RISC-V-Azedinha/RISC-V/figura_double_buffering_tcc.png

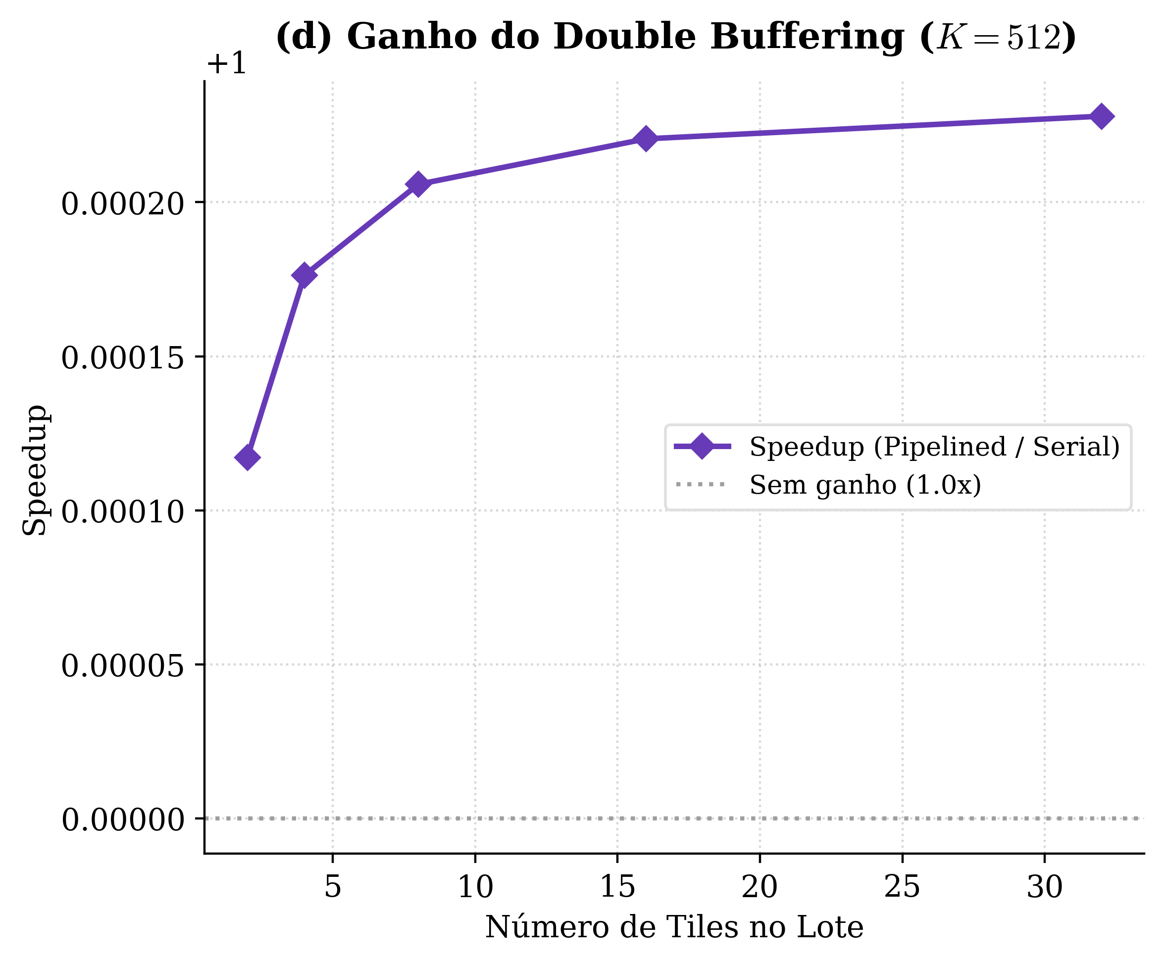
figura_double_buffering_tcc.png
