RISC-V-Azedinha/RISC-V/tight_setup_hold_pins.txt

+====================+===================+=======================================================================+
| Launch Setup Clock | Launch Hold Clock | Pin                                                                   |
+====================+===================+=======================================================================+
| sys_clk_pin        | sys_clk_pin       | U_CORE/U_CONTROLPATH/u_main_fsm/FSM_sequential_current_state_reg[1]/D |
+--------------------+-------------------+-----------------------------------------------------------------------+
