RISC-V-Azedinha/RISC-V/rtl/soc/soc_top.vhd

------------------------------------------------------------------------------------------------------------------
-- 
-- File: soc_top.vhd
-- 
--   ███████╗ ██████╗  ██████╗    ████████╗ ██████╗ ██████╗ 
--   ██╔════╝██╔═══██╗██╔════╝    ╚══██╔══╝██╔═══██╗██╔══██╗
--   ███████╗██║   ██║██║            ██║   ██║   ██║██████╔╝
--   ╚════██║██║   ██║██║            ██║   ██║   ██║██╔═══╝ 
--   ███████║╚██████╔╝╚██████╗       ██║   ╚██████╔╝██║     
--   ╚══════╝ ╚═════╝  ╚═════╝       ╚═╝    ╚═════╝ ╚═╝     
-- 
-- Descrição : Top-level do SoC RISC-V.
--             Integra o núcleo processador com memórias e periféricos reais.
--             Arquitetura: Harvard Modificada com Crossbar e DMA Dual-Master.
-- 
------------------------------------------------------------------------------------------------------------------

library ieee;
use ieee.std_logic_1164.all;
use ieee.numeric_std.all;

entity soc_top is
    generic (
        INIT_FILE : string  := "build/fpga/boot/bootloader.hex";
        CLK_FREQ  : integer := 100_000_000;  
        BAUD_RATE : integer := 921_600;
        BAUD_RATE_UART2 : integer := 115_200     -- UART2 no Pmod JA (ex.: ponte Bluetooth com um ESP32)
    );
    port (
        CLK_i       : in  std_logic;         
        Reset_i     : in  std_logic;         
        
        UART_TX_o   : out std_logic;         
        UART_RX_i   : in  std_logic;         
        UART_RTS_i  : in  std_logic;         

        GPIO_LEDS_o : out std_logic_vector(15 downto 0);
        GPIO_SW_i   : in  std_logic_vector(15 downto 0);
        GPIO_BTN_i  : in  std_logic_vector( 3 downto 0) := (others => '0');   -- BTNU, BTND, BTNL, BTNR

        -- Pmods JA..JD (bit i = pino i da porta: pinos 1-4 e 7-10 do conector)
        PMOD_JA_io  : inout std_logic_vector(7 downto 0);
        PMOD_JB_io  : inout std_logic_vector(7 downto 0);
        PMOD_JC_io  : inout std_logic_vector(7 downto 0);
        PMOD_JD_io  : inout std_logic_vector(7 downto 0);

        -- LEDs RGB LD16 e LD17 (bit 0 = R, 1 = G, 2 = B)
        RGB0_o      : out std_logic_vector(2 downto 0);
        RGB1_o      : out std_logic_vector(2 downto 0);

        VGA_HS_o    : out std_logic;
        VGA_VS_o    : out std_logic;
        VGA_R_o     : out std_logic_vector(3 downto 0);
        VGA_G_o     : out std_logic_vector(3 downto 0);
        VGA_B_o     : out std_logic_vector(3 downto 0);

        -- Displays de 7 segmentos (ativos em nível baixo)
        SEG_CAT_o   : out std_logic_vector(6 downto 0);                       -- CA..CG
        SEG_DP_o    : out std_logic;
        SEG_AN_o    : out std_logic_vector(7 downto 0);

        -- Slot de microSD (modo SPI)
        SD_SCK_o    : out std_logic;
        SD_CMD_o    : out std_logic;                                          -- MOSI
        SD_DAT0_i   : in  std_logic := '1';                                   -- MISO
        SD_DAT_o    : out std_logic_vector(3 downto 1);                       -- DAT3 = CS; DAT1 e DAT2 em 1
        SD_RESET_o  : out std_logic;                                          -- 1 = cartão sem alimentação
        SD_CD_i     : in  std_logic := '1'                                    -- 0 = cartão no slot
    );
end entity;

architecture rtl of soc_top is

    -- === Sinais da CPU ==========================================================================================
    signal s_cpu_imem_addr   : std_logic_vector(31 downto 0);
    signal s_cpu_imem_data   : std_logic_vector(31 downto 0);
    signal s_cpu_imem_vld    : std_logic;
    signal s_cpu_imem_rdy    : std_logic;

    signal s_cpu_dmem_addr   : std_logic_vector(31 downto 0);
    signal s_cpu_dmem_wdata  : std_logic_vector(31 downto 0);
    signal s_cpu_dmem_rdata  : std_logic_vector(31 downto 0);
    signal s_cpu_dmem_we     : std_logic_vector( 3 downto 0);
    signal s_cpu_dmem_vld    : std_logic;
    signal s_cpu_dmem_rdy    : std_logic;

    -- === Sinais do DMA ==========================================================================================
    signal s_dma_m_rd_addr   : std_logic_vector(31 downto 0);
    signal s_dma_m_rd_data   : std_logic_vector(31 downto 0);
    signal s_dma_m_rd_vld    : std_logic;
    signal s_dma_m_rd_rdy    : std_logic;

    signal s_dma_m_wr_addr   : std_logic_vector(31 downto 0);
    signal s_dma_m_wr_data   : std_logic_vector(31 downto 0);
    signal s_dma_m_wr_we     : std_logic;
    signal s_dma_m_wr_vld    : std_logic;
    signal s_dma_m_wr_rdy    : std_logic;

    signal s_dma_s_addr      : std_logic_vector(3 downto 0);
    signal s_dma_s_wdata     : std_logic_vector(31 downto 0);
    signal s_dma_s_rdata     : std_logic_vector(31 downto 0);
    signal s_dma_s_we        : std_logic;
    signal s_dma_s_vld       : std_logic;
    signal s_dma_s_rdy       : std_logic;

    -- === Sinais de Interconexão (Periféricos e Memórias) ========================================================
    signal s_rom_addr_a, s_rom_addr_b : std_logic_vector(31 downto 0);
    signal s_rom_data_a, s_rom_data_b : std_logic_vector(31 downto 0);
    signal s_rom_vld_a, s_rom_rdy_a   : std_logic;
    signal s_rom_vld_b, s_rom_rdy_b   : std_logic;

    signal s_ram_addr_a, s_ram_addr_b : std_logic_vector(31 downto 0);
    signal s_ram_data_a, s_ram_data_b : std_logic_vector(31 downto 0);     
    signal s_ram_data_w               : std_logic_vector(31 downto 0);
    signal s_ram_we_b                 : std_logic_vector( 3 downto 0);
    signal s_ram_vld_a, s_ram_rdy_a   : std_logic;
    signal s_ram_vld_b, s_ram_rdy_b   : std_logic;

    signal s_uart_addr                : std_logic_vector( 3 downto 0);
    signal s_uart_data_rx             : std_logic_vector(31 downto 0);
    signal s_uart_data_tx             : std_logic_vector(31 downto 0);
    signal s_uart_we                  : std_logic;
    signal s_uart_vld, s_uart_rdy     : std_logic;

    signal s_gpio_addr                : std_logic_vector(9 downto 0);
    signal s_gpio_data_rx             : std_logic_vector(31 downto 0);                 
    signal s_gpio_data_tx             : std_logic_vector(31 downto 0);
    signal s_gpio_we                  : std_logic;
    signal s_gpio_vld, s_gpio_rdy     : std_logic;

    signal s_vga_addr                 : std_logic_vector(16 downto 0);
    signal s_vga_data_rx              : std_logic_vector(31 downto 0);                  
    signal s_vga_data_tx              : std_logic_vector(31 downto 0);
    signal s_vga_we                   : std_logic;
    signal s_vga_vld, s_vga_rdy       : std_logic;

    signal s_npu_addr                 : std_logic_vector(31 downto 0);
    signal s_npu_data_rx              : std_logic_vector(31 downto 0);                 
    signal s_npu_data_tx              : std_logic_vector(31 downto 0);
    signal s_npu_we                   : std_logic;
    signal s_npu_vld, s_npu_rdy       : std_logic;
    signal s_npu_rst_n                : std_logic;

    signal s_clint_addr               : std_logic_vector(4 downto 0);
    signal s_clint_data_rx            : std_logic_vector(31 downto 0);
    signal s_clint_data_tx            : std_logic_vector(31 downto 0);
    signal s_clint_we                 : std_logic;
    signal s_clint_vld, s_clint_rdy   : std_logic;

    signal s_plic_addr                : std_logic_vector(23 downto 0);
    signal s_plic_data_rx             : std_logic_vector(31 downto 0);
    signal s_plic_data_tx             : std_logic_vector(31 downto 0);
    signal s_plic_we                  : std_logic;
    signal s_plic_vld, s_plic_rdy     : std_logic;

    signal s_sd_addr                  : std_logic_vector(3 downto 0);
    signal s_sd_data_rx               : std_logic_vector(31 downto 0);
    signal s_sd_data_tx               : std_logic_vector(31 downto 0);
    signal s_sd_we                    : std_logic;
    signal s_sd_vld, s_sd_rdy         : std_logic;

    signal s_uart2_addr               : std_logic_vector(3 downto 0);
    signal s_uart2_data_rx            : std_logic_vector(31 downto 0);
    signal s_uart2_data_tx            : std_logic_vector(31 downto 0);
    signal s_uart2_we                 : std_logic;
    signal s_uart2_vld, s_uart2_rdy   : std_logic;

    -- === Auxiliares =============================================================================================
    signal s_irq_external             : std_logic;
    signal s_irq_timer                : std_logic;
    signal s_irq_soft                 : std_logic;

    signal s_uart_irq                 : std_logic;
    signal s_dma_irq                  : std_logic;
    signal s_npu_irq                  : std_logic;
    signal s_plic_sources             : std_logic_vector(31 downto 0);
    signal s_gpio_irq                 : std_logic;
    signal s_uart2_irq                : std_logic;

    -- Pmods: valor, habilitação de saída (tri-state) e leitura de cada pino
    signal s_ja_o, s_jb_o, s_jc_o, s_jd_o     : std_logic_vector(7 downto 0);
    signal s_ja_oe, s_jb_oe, s_jc_oe, s_jd_oe : std_logic_vector(7 downto 0);

    -- UART2 no Pmod JA: quando habilitada (bit EN), toma os pinos 2 (TX) e 3 (RX); senão, são GPIO
    signal s_uart2_en                 : std_logic;
    signal s_uart2_tx, s_uart2_rx     : std_logic;
    signal s_ja_pin_o, s_ja_pin_oe    : std_logic_vector(7 downto 0);

    -- === Controle de DEBUG ======================================================================================
    signal s_soc_en                   : std_logic;
    signal s_soc_en_sys               : std_logic := '1'; -- PIPELINE: Atraso de 1 ciclo para periféricos
    signal s_is_fetch_stage           : std_logic;
    signal s_debug_rst                : std_logic;
    signal s_sys_rst                  : std_logic;

    signal s_uart_rx_soc              : std_logic;
    signal s_uart_rx_debug            : std_logic;
    signal s_uart_tx_soc              : std_logic;
    signal s_uart_tx_debug            : std_logic;

    signal s_debug_reg_addr           : std_logic_vector(4 downto 0);
    signal s_debug_reg_data           : std_logic_vector(31 downto 0);
    signal s_dbg_boot_addr            : std_logic_vector(31 downto 0);
    signal s_dbg_reg_clr              : std_logic;

begin

    -- ============================================================================================================
    -- PIPELINE DO SINAL DE DEBUG (QUEBRA O CRITICAL PATH)
    -- ============================================================================================================
    process(CLK_i)
    begin
        if rising_edge(CLK_i) then
            s_soc_en_sys <= s_soc_en;
        end if;
    end process;

    -- ============================================================================================================
    -- CONTROLE DE RESET E INTERRUPÇÕES
    -- ============================================================================================================
    s_sys_rst <= Reset_i OR s_debug_rst;

    s_plic_sources <= (
        1 => s_uart_irq, 
        2 => s_dma_irq,
        3 => s_npu_irq,
        4 => s_gpio_irq,
        5 => s_uart2_irq,
        others => '0'
    );

    -- ============================================================================================================
    -- MULTIPLEXAÇÃO FÍSICA DE DEBUG VIA RTS
    -- ============================================================================================================
    s_uart_rx_soc   <= UART_RX_i when UART_RTS_i = '0' else '1';
    s_uart_rx_debug <= UART_RX_i when UART_RTS_i = '1' else '1';
    
    -- O TX usa o sinal system-level pipelined para prevenir timing violations na board
    UART_TX_o       <= s_uart_tx_debug when (UART_RTS_i = '1' or s_soc_en_sys = '0') else s_uart_tx_soc;

    -- ============================================================================================================
    -- DEBUG CONTROLLER
    -- ============================================================================================================
    U_DEBUG: entity work.debug_controller
        generic map (
            CLK_FREQ         => CLK_FREQ,
            BAUD_RATE        => BAUD_RATE
        )
        port map (
            clk_i            => CLK_i,
            rst_i            => Reset_i,
            dbg_boot_addr_o  => s_dbg_boot_addr,
            dbg_reg_clr_o    => s_dbg_reg_clr,
            uart_rx_i        => s_uart_rx_debug,
            uart_tx_o        => s_uart_tx_debug,
            uart_rts_i       => UART_RTS_i,
            is_fetch_stage_i => s_is_fetch_stage,
            soc_en_o         => s_soc_en,
            debug_rst_o      => s_debug_rst,
            reg_addr_o       => s_debug_reg_addr,
            reg_data_i       => s_debug_reg_data,
            pc_i             => s_cpu_imem_addr
        );

    -- ============================================================================================================
    -- NÚCLEO PROCESSADOR (CPU)
    -- ============================================================================================================
    U_CORE: entity work.processor_top
        port map (
            CLK_i               => CLK_i,
            Reset_i             => s_sys_rst,
            dbg_boot_addr_i     => s_dbg_boot_addr,
            dbg_reg_clr_i       => s_dbg_reg_clr,
            soc_en_i            => s_soc_en, -- MANTÉM COMBINACIONAL para travagem instantânea do PC
            is_fetch_stage_o    => s_is_fetch_stage,
            debug_reg_addr_i    => s_debug_reg_addr,
            debug_reg_data_o    => s_debug_reg_data,
            IMem_addr_o         => s_cpu_imem_addr,
            IMem_data_i         => s_cpu_imem_data,
            IMem_vld_o          => s_cpu_imem_vld, 
            IMem_rdy_i          => s_cpu_imem_rdy,
            DMem_addr_o         => s_cpu_dmem_addr,
            DMem_data_o         => s_cpu_dmem_wdata,
            DMem_data_i         => s_cpu_dmem_rdata,
            DMem_we_o           => s_cpu_dmem_we,
            DMem_rdy_i          => s_cpu_dmem_rdy,
            DMem_vld_o          => s_cpu_dmem_vld,
            Irq_External_i      => s_irq_external,
            Irq_Timer_i         => s_irq_timer,
            Irq_Software_i      => s_irq_soft
        );

    -- ============================================================================================================
    -- DMA CONTROLLER (Dual-Master)
    -- ============================================================================================================
    U_DMA: entity work.dma_controller
        port map (
            clk_i       => CLK_i,
            rst_i       => s_sys_rst,
            soc_en_i    => s_soc_en_sys, -- PIPELINE: Resolve a Violação de Timing de -4.271ns
            
            -- Slave (Config)
            cfg_addr_i  => s_dma_s_addr,
            cfg_data_i  => s_dma_s_wdata, 
            cfg_data_o  => s_dma_s_rdata, 
            cfg_we_i    => s_dma_s_we,
            cfg_vld_i   => s_dma_s_vld,
            cfg_rdy_o   => s_dma_s_rdy,
            
            -- Master Read (Source)
            m_rd_addr_o => s_dma_m_rd_addr,
            m_rd_vld_o  => s_dma_m_rd_vld,
            m_rd_data_i => s_dma_m_rd_data,
            m_rd_rdy_i  => s_dma_m_rd_rdy,

            -- Master Write (Destino)
            m_wr_addr_o => s_dma_m_wr_addr,
            m_wr_data_o => s_dma_m_wr_data,
            m_wr_we_o   => s_dma_m_wr_we,
            m_wr_vld_o  => s_dma_m_wr_vld,
            m_wr_rdy_i  => s_dma_m_wr_rdy,
            
            irq_done_o  => s_dma_irq
        );

    -- ============================================================================================================
    -- HUB DE INTERCONEXÃO (CROSSBAR INTERCONNECT)
    -- ============================================================================================================
    U_BUS: entity work.bus_interconnect
        port map (
            -- Sinais Globais
            clk_i => CLK_i,
            rst_i => s_sys_rst,

            -- Interface Core: IMem (CPU Direto)
            imem_addr_i => s_cpu_imem_addr,
            imem_data_o => s_cpu_imem_data,
            imem_vld_i  => s_cpu_imem_vld, 
            imem_rdy_o  => s_cpu_imem_rdy,

            -- Master 0: CPU DMem 
            cpu_addr_i  => s_cpu_dmem_addr,
            cpu_data_i  => s_cpu_dmem_wdata,
            cpu_we_i    => s_cpu_dmem_we,
            cpu_vld_i   => s_cpu_dmem_vld,
            cpu_data_o  => s_cpu_dmem_rdata,
            cpu_rdy_o   => s_cpu_dmem_rdy,

            -- Master 1: DMA Read
            dma_rd_addr_i => s_dma_m_rd_addr,
            dma_rd_vld_i  => s_dma_m_rd_vld,
            dma_rd_data_o => s_dma_m_rd_data,
            dma_rd_rdy_o  => s_dma_m_rd_rdy,

            -- Master 2: DMA Write
            dma_wr_addr_i => s_dma_m_wr_addr,
            dma_wr_data_i => s_dma_m_wr_data,
            dma_wr_we_i   => s_dma_m_wr_we,
            dma_wr_vld_i  => s_dma_m_wr_vld,
            dma_wr_rdy_o  => s_dma_m_wr_rdy,

            -- Interface ROM
            rom_addr_a_o => s_rom_addr_a, rom_data_a_i => s_rom_data_a,
            rom_addr_b_o => s_rom_addr_b, rom_data_b_i => s_rom_data_b,
            rom_vld_a_o  => s_rom_vld_a,  rom_rdy_a_i  => s_rom_rdy_a,
            rom_vld_b_o  => s_rom_vld_b,  rom_rdy_b_i  => s_rom_rdy_b,

            -- Interface RAM
            ram_addr_a_o => s_ram_addr_a, ram_data_a_i => s_ram_data_a,
            ram_addr_b_o => s_ram_addr_b, ram_data_b_i => s_ram_data_b,
            ram_data_b_o => s_ram_data_w,                      
            ram_we_b_o   => s_ram_we_b,
            ram_vld_a_o  => s_ram_vld_a,  ram_rdy_a_i  => s_ram_rdy_a,
            ram_vld_b_o  => s_ram_vld_b,  ram_rdy_b_i  => s_ram_rdy_b,

            -- Interface UART
            uart_addr_o  => s_uart_addr,    uart_data_i  => s_uart_data_rx,
            uart_data_o  => s_uart_data_tx, uart_we_o    => s_uart_we,
            uart_vld_o   => s_uart_vld,     uart_rdy_i   => s_uart_rdy,

            -- Interface GPIO
            gpio_addr_o  => s_gpio_addr,    gpio_data_i  => s_gpio_data_rx,
            gpio_data_o  => s_gpio_data_tx, gpio_we_o    => s_gpio_we,
            gpio_vld_o   => s_gpio_vld,     gpio_rdy_i   => s_gpio_rdy,

            -- Interface VGA
            vga_addr_o   => s_vga_addr,     vga_data_i   => s_vga_data_rx,
            vga_data_o   => s_vga_data_tx,  vga_we_o     => s_vga_we,
            vga_vld_o    => s_vga_vld,      vga_rdy_i    => s_vga_rdy,

            -- Interface NPU 
            npu_addr_o   => s_npu_addr,     npu_data_i   => s_npu_data_rx,
            npu_data_o   => s_npu_data_tx,  npu_we_o     => s_npu_we,
            npu_vld_o    => s_npu_vld,      npu_rdy_i    => s_npu_rdy,
            
            -- DMA Slave (Config)
            dma_addr_o   => s_dma_s_addr,
            dma_data_i   => s_dma_s_rdata, 
            dma_data_o   => s_dma_s_wdata, 
            dma_we_o     => s_dma_s_we,
            dma_vld_o    => s_dma_s_vld,
            dma_rdy_i    => s_dma_s_rdy,

            -- Interface CLINT
            clint_addr_o  => s_clint_addr,
            clint_data_i  => s_clint_data_rx,
            clint_data_o  => s_clint_data_tx,
            clint_we_o    => s_clint_we,
            clint_vld_o   => s_clint_vld,
            clint_rdy_i   => s_clint_rdy,

            -- Interface PLIC
            plic_addr_o   => s_plic_addr, 
            plic_data_i   => s_plic_data_rx, 
            plic_data_o   => s_plic_data_tx, 
            plic_we_o     => s_plic_we, 
            plic_vld_o    => s_plic_vld, 
            plic_rdy_i    => s_plic_rdy,

            -- Interface do cartão SD
            sd_addr_o     => s_sd_addr,
            sd_data_i     => s_sd_data_rx,
            sd_data_o     => s_sd_data_tx,
            sd_we_o       => s_sd_we,
            sd_vld_o      => s_sd_vld,
            sd_rdy_i      => s_sd_rdy,

            -- Interface da UART2 (Pmod JA)
            uart2_addr_o  => s_uart2_addr,
            uart2_data_i  => s_uart2_data_rx,
            uart2_data_o  => s_uart2_data_tx,
            uart2_we_o    => s_uart2_we,
            uart2_vld_o   => s_uart2_vld,
            uart2_rdy_i   => s_uart2_rdy
        );

    -- ============================================================================================================
    -- COMPONENTES DO SISTEMA
    -- ============================================================================================================

    U_ROM: entity work.boot_rom
        generic map ( INIT_FILE => INIT_FILE )
        port map (
            clk      => CLK_i,
            vld_a_i  => s_rom_vld_a, rdy_a_o  => s_rom_rdy_a, addr_a_i => s_rom_addr_a, data_a_o => s_rom_data_a,
            vld_b_i  => s_rom_vld_b, addr_b_i => s_rom_addr_b, data_b_o => s_rom_data_b, rdy_b_o  => s_rom_rdy_b
        );

    U_RAM: entity work.dual_port_ram
        generic map (ADDR_WIDTH => 16)  
        port map (
            clk      => CLK_i,
            vld_a_i  => s_ram_vld_a, rdy_a_o => s_ram_rdy_a, we_a => (others => '0'), addr_a => s_ram_addr_a(17 downto 2), data_a_i => (others => '0'), data_a_o => s_ram_data_a,
            vld_b_i  => s_ram_vld_b, we_b => s_ram_we_b, addr_b => s_ram_addr_b(17 downto 2), data_b_i => s_ram_data_w, data_b_o => s_ram_data_b, rdy_b_o => s_ram_rdy_b
        );

    U_UART : entity work.uart_controller
        generic map ( CLK_FREQ => CLK_FREQ, BAUD_RATE => BAUD_RATE )
        port map (
            clk => CLK_i, rst => s_sys_rst, addr_i => s_uart_addr, data_i => s_uart_data_tx, data_o => s_uart_data_rx, rdy_o => s_uart_rdy, we_i => s_uart_we, vld_i => s_uart_vld, uart_tx_pin => s_uart_tx_soc, uart_rx_pin => s_uart_rx_soc, irq_o => s_uart_irq
        );

    U_UART2 : entity work.uart_controller
        generic map ( CLK_FREQ => CLK_FREQ, BAUD_RATE => BAUD_RATE_UART2 )
        port map (
            clk => CLK_i, rst => s_sys_rst, addr_i => s_uart2_addr, data_i => s_uart2_data_tx, data_o => s_uart2_data_rx, rdy_o => s_uart2_rdy, we_i => s_uart2_we, vld_i => s_uart2_vld, uart_tx_pin => s_uart2_tx, uart_rx_pin => s_uart2_rx, irq_o => s_uart2_irq, en_o => s_uart2_en
        );

    U_GPIO: entity work.gpio_controller
        port map (
            clk => CLK_i, rst => s_sys_rst, vld_i => s_gpio_vld, we_i => s_gpio_we, addr_i => s_gpio_addr, data_i => s_gpio_data_tx, data_o => s_gpio_data_rx, rdy_o => s_gpio_rdy, irq_o => s_gpio_irq,
            ja_i => PMOD_JA_io, jb_i => PMOD_JB_io, jc_i => PMOD_JC_io, jd_i => PMOD_JD_io,
            ja_o => s_ja_o, jb_o => s_jb_o, jc_o => s_jc_o, jd_o => s_jd_o,
            ja_oe_o => s_ja_oe, jb_oe_o => s_jb_oe, jc_oe_o => s_jc_oe, jd_oe_o => s_jd_oe,
            gpio_leds => GPIO_LEDS_o, gpio_sw => GPIO_SW_i, gpio_btn => GPIO_BTN_i,
            seg_n_o => SEG_CAT_o, dp_n_o => SEG_DP_o, an_n_o => SEG_AN_o,
            rgb0_o => RGB0_o, rgb1_o => RGB1_o
        );

    -- Multiplexação do Pmod JA: com a UART2 habilitada, o pino 2 (bit 1) é o TX e o pino 3 (bit 2) é o RX,
    -- como na interface UART do padrão Pmod (Tipo 3). Os demais pinos, e todos com a UART2 desabilitada,
    -- continuam com o GPIO. A leitura do GPIO (registrador IN) enxerga os pinos nos dois casos.
    process(all)
    begin
        s_ja_pin_o  <= s_ja_o;
        s_ja_pin_oe <= s_ja_oe;
        if s_uart2_en = '1' then
            s_ja_pin_o(1)  <= s_uart2_tx;
            s_ja_pin_oe(1) <= '1';
            s_ja_pin_oe(2) <= '0';
        end if;
    end process;

    s_uart2_rx <= PMOD_JA_io(2) when s_uart2_en = '1' else '1';     -- Desabilitada: linha em repouso

    -- Tri-state dos Pmods: cada pino só é dirigido quando a sua direção é saída
    GEN_PMOD: for i in 0 to 7 generate
        PMOD_JA_io(i) <= s_ja_pin_o(i) when s_ja_pin_oe(i) = '1' else 'Z';
        PMOD_JB_io(i) <= s_jb_o(i) when s_jb_oe(i) = '1' else 'Z';
        PMOD_JC_io(i) <= s_jc_o(i) when s_jc_oe(i) = '1' else 'Z';
        PMOD_JD_io(i) <= s_jd_o(i) when s_jd_oe(i) = '1' else 'Z';
    end generate;

    U_VGA: entity work.vga_peripheral
        port map (
            clk => CLK_i, rst => s_sys_rst, we_i => s_vga_we, addr_i => s_vga_addr, data_i => s_vga_data_tx, data_o => s_vga_data_rx, rdy_o => s_vga_rdy, vld_i => s_vga_vld, vga_hs_o => VGA_HS_o, vga_vs_o => VGA_VS_o, vga_r_o => VGA_R_o, vga_g_o => VGA_G_o, vga_b_o => VGA_B_o
        );

    U_CLINT: entity work.clint
        port map (
            clk_i => CLK_i, rst_i => s_sys_rst, soc_en_i => s_soc_en_sys, addr_i => s_clint_addr, data_i => s_clint_data_tx, data_o => s_clint_data_rx, we_i => s_clint_we, vld_i => s_clint_vld, rdy_o => s_clint_rdy, irq_timer_o => s_irq_timer, irq_soft_o => s_irq_soft
        );

    U_PLIC: entity work.plic
        port map (
            Clk_i => CLK_i, Reset_i => s_sys_rst, Addr_i => s_plic_addr, Data_i => s_plic_data_tx, Data_o => s_plic_data_rx, We_i => s_plic_we, Vld_i => s_plic_vld, Rdy_o => s_plic_rdy, Irq_Sources_i => s_plic_sources, Irq_Req_o => s_irq_external
        );

    U_SD: entity work.sd_spi
        port map (
            clk => CLK_i, rst => s_sys_rst, vld_i => s_sd_vld, we_i => s_sd_we, addr_i => s_sd_addr, data_i => s_sd_data_tx, data_o => s_sd_data_rx, rdy_o => s_sd_rdy,
            sd_sck_o => SD_SCK_o, sd_mosi_o => SD_CMD_o, sd_miso_i => SD_DAT0_i, sd_cs_n_o => SD_DAT_o(3), sd_reset_o => SD_RESET_o, sd_cd_n_i => SD_CD_i
        );

    SD_DAT_o(2 downto 1) <= "11";                       -- Sem uso no modo SPI

    s_npu_rst_n <= not s_sys_rst;

    U_NPU: entity work.npu_top
        generic map (
            DOUBLE_BUFFER => true
        )
        port map (
            clk => CLK_i, rst_n => s_npu_rst_n, soc_en_i => s_soc_en_sys, vld_i => s_npu_vld, we_i => s_npu_we, addr_i => s_npu_addr, data_i => s_npu_data_tx, data_o => s_npu_data_rx, rdy_o => s_npu_rdy, irq_done_o => s_npu_irq
        );

end architecture;
