RISC-V-Azedinha/RISC-V/tools/bench_v2.py

"""
Benchmark v2 da NPU: avaliação por camada e por mecanismo, autovalidada.

Cada ponto é um experimento 'X' no bench_server (fpga/sw/server/bench_server.c): uma camada
(densa ou convolução) executada com um conjunto de mecanismos da NPU ligados/desligados. O SoC
devolve a decomposição em ciclos (pesos, entradas, execução), as palavras que atravessaram o
barramento, os MACs úteis e dos PEs, e o número de saídas que divergem da referência na CPU.

Experimentos (ver MEMORIAL_BENCH_V2.md):
  E1  Validação: todas as configurações, 0 divergências exigidas
  E2  Varredura de intensidade operacional (roofline): densa e convolução, pesos via DMA x residentes
  E3  Ablação na CNN do MNIST (Conv 28x28/3x3/2 e Densa 676->12): cumulativa e "deixa um de fora"
  E4  Independência de dados e esparsidade: NPU x CPU em função da fração de zeros
  E5  CNN completa (Conv + densa encadeadas): streaming, tiles encadeados, fusão e DMA da saída
  E6  Varredura de K no GEMM 4x4 (o cenário do benchmark original), NPU original x otimizada
  E7  Por tipo de operação: Conv2D (tamanho da imagem) e densa lote 1 (K), NPU base x otimizada

Uso:
  python3 tools/bench_v2.py --upload build/fpga/bin/bench_server.bin --port /dev/ttyUSB1
  python3 tools/bench_v2.py --quick            (menos pontos e repetições)
"""
import argparse
import csv
import os
import statistics
import struct
import sys
import time

import serial

KIND_DENSE, KIND_CONV, KIND_CNN = 0, 1, 2
(F_RESIDENT, F_SEQ, F_OUT_DMA, F_GEMV, F_IM2COL, F_BATCH4, F_CPU_REF,
 F_STREAM, F_OVERLAP, F_FUSE, F_RBIAS, F_DESC) = (1 << i for i in range(12))
FLAG_NAMES = [(F_RESIDENT, "resid"), (F_SEQ, "seq"), (F_OUT_DMA, "outdma"), (F_GEMV, "gemv"),
              (F_IM2COL, "im2col"), (F_BATCH4, "lote4"), (F_OVERLAP, "encad"), (F_STREAM, "stream"),
              (F_FUSE, "fusao"), (F_RBIAS, "rbias"), (F_DESC, "desc")]
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
