RISC-V-Azedinha/RISC-V/(commit log)

2026-02-27 feat(soc): integrate debug controller and Y-split UART via RTS
2026-02-27 feat(soc): add reset command via debug_controller
    [debug_controller.vhd, soc_top.vhd]
2026-02-27 feat(build): add auto-reset to upload
    [upload.py]
2026-02-28 fix(debug): remove breakpoint race condition conflict
    [debug_controller.vhd, main_fsm.vhd]
2026-03-15 docs: adiciona template de pull request
2026-03-25 docs: finaliza a doc do barramento (#19)
    * docs: finaliza a doc do barramento
    * docs: adiciona link para documentacao do protocolo ready/valid
2026-04-20 docs: interrupecoes plic e clint (#29)
    * docs: interrupecoes plic e clint
    * Update interrupts.md
2026-04-22 docs: documenta Memória e DMA (#21)
    * docs: documenta Memória e DMA
    * docs: adiciona diagramas
    * fix: ajusta algumas informações equivocadas na doc de memoria_dma
2026-04-27 docs: add fpga synthesis and implementation flow documentation (#27)
    * docs: add fpga synthesis and implementation flow documentation
    * docs: comprehensive update and technical refinement of fpga_build.md
2026-05-02 docs: adiciona documentação de ferramentas python de ia (#20)
    * adiciona documentação de ferramentas python de ia
    * docs: adiciona Toolchain e Build System | fix: ajuste no clientes_inteligencia_artificial
    * docs: atualiza clientes de IA e adiciona documentação de toolchain
    * docs: criei Documentar Apps e Servidores IA
    * docs: refine toolchain and build system documentation with memory layout and FPGA flow
    * docs: refine terminology by introducing Edge AI concept in inference description
    * docs: refine GUI documentation focusing on debug toolchain and system architecture
2026-05-02 docs: update documentation for the UART and GPIO controllers (#24)
    * docs(risc-v #7): implementa documentacao gpio
    * docs(risc-v #7): implementa documentacao uart
    * docs: update documentation for the UART and GPIO controllers
    * docs: correct baud rate value and typo
    ---------
2026-05-03 fix(build): reapply build system refactor after history rewrite issue
    [alu.vhd, alu_control.vhd, boot.c, boot_rom.vhd, branch_unit.vhd, bus_interconnect.vhd, clint.vhd, console_test.c]
2026-05-03 test(unit): test uart_controller peripheral
2026-05-09 feat(mlp): add led gpio
2026-05-15 feat(dma): decouple dma write and read
2026-05-16 fix(perips): add edge guard to gpio_controller vld signal
    [gpio_controller.vhd]
2026-05-16 test(perips): add edge guard to uart_controller
2026-05-16 test(perips): add edge guard to interrupt and dma controllers
2026-05-16 chore: Atualiza submódulo NPU com arquitetura de Edge Guard
2026-05-16 feat(rtl): increase dma elastic buffer
2026-05-17 fix(fpga): register soc_en signal resolving timing issues
    [debug_controller.vhd, debugger.py, soc_top.vhd]
2026-08-17 fix: improve timing closure
    [bus_interconnect.vhd, dma_controller.vhd, vga_peripheral.vhd]
2026-09-13 feat: altera empacotamento de ativacoes para o DMA
2026-09-13 perf(sw): alimenta a NPU com 4 DMAs e funde im2col com empacotamento
    - Conv: as 387 palavras de entrada dos 43 grupos e os 9 pesos seguem em
    duas transferências de DMA; cada passagem reinicia só a leitura dos
    pesos (0x16) e o ponteiro de leitura das entradas avança sozinho
    - FC: os pesos dos 3 blocos (2028 palavras) seguem num único DMA; cada
    passagem reinicia só a leitura das entradas (0x26)
    - image_to_packed monta as janelas e as empacota numa única passada
    - a Conv grava a saída direto em fc_in_words (formato de entrada da FC)
    Medido na placa (100 imagens, logits bit a bit iguais à emulação):
    latência 13,94 -> 11,93 ms; tempo no SoC 4,83 -> 2,27 ms.
2026-09-17 feat(fpga): adiciona suporte à Nexys A7 com seleção de placa no makefile
    - BOARD=nexys4 (padrão) | nexys_a7 em fpga-build, fpga-prog e fpga-flash
    - fpga/scripts/board.tcl centraliza part, constraints e Flash de cada placa
    (recebe a placa via -tclargs; FLASH_PART sobrescreve a memória)
    - pins.xdc separado em common.xdc (clock, config, multicycle) e na
    pinagem de cada placa: nexys4.xdc e nexys_a7.xdc (SW8/SW9 em LVCMOS18)
    - saídas em build/fpga/<placa>/, evitando gravar bitstream da placa errada
    - program.tcl e flash.tcl falham com mensagem clara se .bit/.mcs ou a
    memória Flash não existirem
    Validado na Nexys A7-100T: timing atendido, upload via UART e gravação
    na Flash (S25FL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
2026-09-17 fix(fpga): mantém apagados os displays de 7 segmentos
    Pinos sem constraint recebem pull-down fraco por padrão no Vivado, o que
    acendia parcialmente os dígitos (ânodos ativos em nível baixo). O soc_top
    agora expõe SEG_AN_o fixo em '1', mapeado nas duas placas.
    [nexys4.xdc, nexys_a7.xdc, soc_top.vhd]
2026-10-09 perf: integra as otimizações de movimentação de dados da NPU ao SoC
    Atualiza o submódulo da NPU (pesos residentes, im2col em hardware,
    sequenciador de tiles, GEMV, streaming, tiles encadeados, fusão de camadas,
    biases residentes e descritores de camada) e adapta o SoC, o firmware e o
    benchmark:
    - SoC:
    - DMA com origem fixa (CTRL bit 2, hal_dma_drain), para esvaziar a FIFO de
    saída da NPU, e estágio registrado na entrada do dado lido.
    - Porta B da RAM principal com pré-busca de leitura sequencial e escrita
    confirmada no próprio ciclo: o DMA passa de ~0,47 para ~0,92 palavra/ciclo.
    - Firmware:
    - Apps da FPGA compilados com -O2 (APP_OPT, sem chamadas implícitas a
    m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
    [bench_server.c, bench_v2.py, cnn_server.c, common.xdc, dma_controller.vhd, dual_port_ram.vhd, hal_dma.c, hal_dma.h]
2026-10-09 feat(gpio): portas no estilo de microcontrolador, displays de 7 segmentos e LEDs RGB
    Hardware (rtl/perips/gpio):
    - gpio_port: porta com IN, OUT, DIR, OUTSET/OUTCLR/OUTTGL e interrupção por
    borda (IE, IES, IFG), sincronização dos pinos e filtro de repique
    - Pmods JA..JD (8 pinos bidirecionais, tri-state), LEDs, chaves e botões
    - seg7_controller: varredura dos 8 displays em hardware (hex ou segmentos crus)
    - rgb_pwm: PWM de 8 bits por cor para LD16/LD17, com brilho máximo de 1/8
    - interrupção do GPIO na fonte 4 do PLIC; endereço do GPIO com 10 bits
    - pinagem da Nexys A7 e da Nexys 4
    Software:
    - HAL hal_gpio (direção + pino, displays, RGB e interrupções)
    - programas migrados par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
2026-10-09 feat(apps): blink mantém o LED aceso enquanto o push button estiver pressionado
2026-10-09 feat(sd): mestre SPI para o slot de microSD
    - sd_spi.vhd: transfere bytes no SPI modo 0 (DATA, CTRL com CS e alimentação do cartão, DIV do SCK
    e STATUS com BUSY e detecção do cartão); 400 kHz após o reset, DIV mínimo 1
    - barramento: novo escravo na faixa 0x7000_0000
    - soc_top e .xdc das duas placas: pinos do slot (SCK, CMD, DAT0..3, SD_RESET e SD_CD)
    - test_sd_spi: 5 testes com um modelo de cartão (escravo SPI); fuzzing do barramento cobre o 0x7
    - memory_map.h: registradores do cartão
    [bus_interconnect.vhd, memory_map.h, nexys4.xdc, nexys_a7.xdc, sd_spi.vhd, soc_top.vhd, test_bus_interconnect.py]
2026-10-09 feat(boot): programa persistente no cartão microSD
    - bootloader: espera a UART por ~1 s; sem upload, carrega o programa gravado no cartão
    (cabeçalho com mágica, tamanho e checksum); sem cartão ou sem programa, espera a UART como antes
    - o bit 31 do tamanho pede a gravação no cartão; tamanho 0 com o bit apaga o programa
    - gravação só no espaço livre antes da primeira partição; não regrava um programa igual
    - CRC7 em todos os comandos e CRC16 nos blocos gravados (há cartões que conferem tudo)
    - pilha do bootloader nos 2 KB abaixo do app; compilado com -Os e --gc-sections
    - upload.py --save / --erase-sd, make upload SAVE=1, make sd-erase
    - sd_image.py: grava o mesmo formato p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
2026-10-09 feat(apps): demonstração visual da placa para gravar no cartão SD
    Texto rolando, cobra e contador nos displays, arco-íris nos LEDs RGB e vai e vem nos LEDs;
    os botões trocam a animação e a velocidade, e as chaves aparecem nos LEDs.
2026-10-09 docs: barramento crossbar atual, protocolo de upload com o cartão SD e linker do bootloader
    - barramento: substitui o árbitro antigo pela arbitragem por escravo do crossbar, com a tabela
    de endereços (cartão SD em 0x7), a trava de transação e o bus fault
    - fpga_build: reset pelo controlador de depuração, janela de ~1 s e bit de gravação no cartão
    - linker: pilha do bootloader em 0x80000800 e opções de compilação dele
    - setup, memoria_dma e index: comandos SAVE=1 e sd-erase, registradores do cartão
2026-10-09 fix(bench): referência na CPU sensível à esparsidade e medição isolada da NPU
    - A multiplicação por software (__mulsi3) percorre os bits do segundo fator e termina quando ele
    zera. Com "x * w", a ordem dos fatores ficava a critério do compilador: na convolução a ativação
    era o segundo fator, mas na densa era o peso, e os zeros das ativações não mudavam o tempo da
    CPU (a figura de esparsidade a mostrava determinística). A ativação agora vai sempre como
    segundo fator (cpu_mul).
    - A referência na CPU e as funções medidas (v2_run, v2_run_cnn) ficam em funções noinline: mudar
    a referência alterava a alocação de registradores do trecho medido e a medida da NPU e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
    [bench_server.c, bench_v2.py]
2026-10-27 feat(soc): UART2 no Pmod JA e servidor da NPU por Bluetooth
    Segunda instância do uart_controller em 0xA000_0000 (115200 bps, fonte 5
    do PLIC), multiplexada nos pinos 2 e 3 do Pmod JA pelo novo registrador
    EN: com EN = 0 o JA continua todo como GPIO.
    - bus_interconnect: escravo 0xA para a UART2
    - hal_uart2 e teste uart2_test (troca de dono do pino, laço de retorno e
    ponte USB <-> UART2)
    - cnn_server_bluetooth: o cnn_server atendendo pela UART2, onde um ESP32
    faz a ponte com o Bluetooth; o cnn_server pelo USB não muda
    - testes unitários do EN e do novo escravo, e documentação
